eSpark-Backup/salah-el-din-fitness-tracker/docs/Dev-Files/Block Diagram/FitnessTracker.jpg

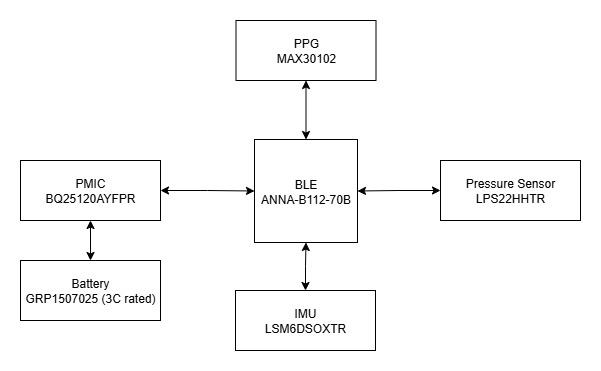
docs/Dev-Files/Block Diagram/FitnessTracker.jpg
