eSpark-Backup/salah-el-din-fitness-tracker/Design-Files/Fitness-Tracker-v1.0/Deliverables/Supporting Files/TrackerPCB-v1.0.step

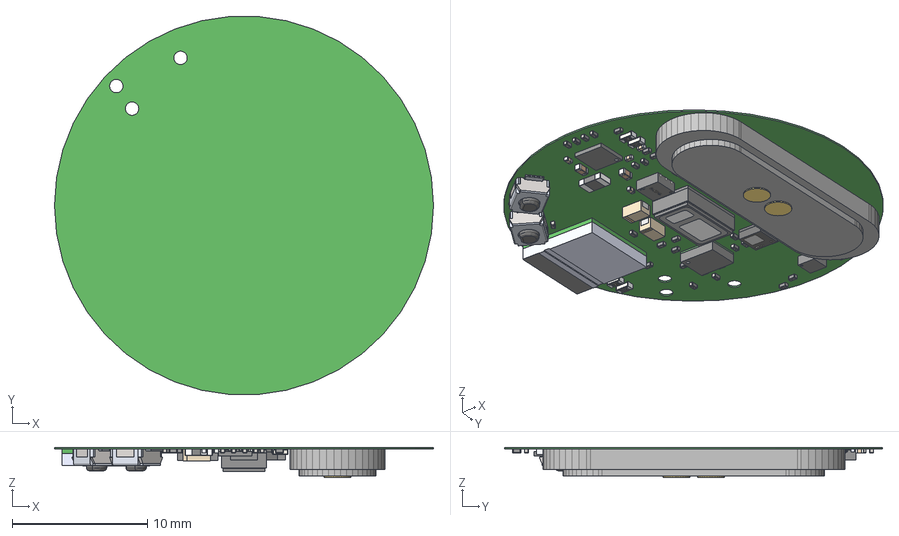
[picture p5: CAD file, 2025-08-07]
Design-Files/Fitness-Tracker-v1.0/Deliverables/Supporting Files/TrackerPCB-v1.0.step
28.0 x 27.9 x 2.22 mm
BQ29702DSER
User Library-0201(0603M) Res x 30
CAP_TR8M_VIS x 2
User Library-SMD Ceramic Capacitors_0201 (0603)_AB x 9
LSM6DSLTR--3DModel-STEP-269445
MAX30102EFD+T
ANNA-B112--3DModel-STEP-56544
User Library-OMRON B3U1000P x 2
User Library-RES_1005-0402 x 4
Extruded x 4
User Library-Capacitor 0402 x 2
