eSpark-Backup/salah-el-din-fitness-tracker/Design-Files/Fitness-Tracker-v1.0/Schematic/Fitness-Tracker-v1.0.pdf

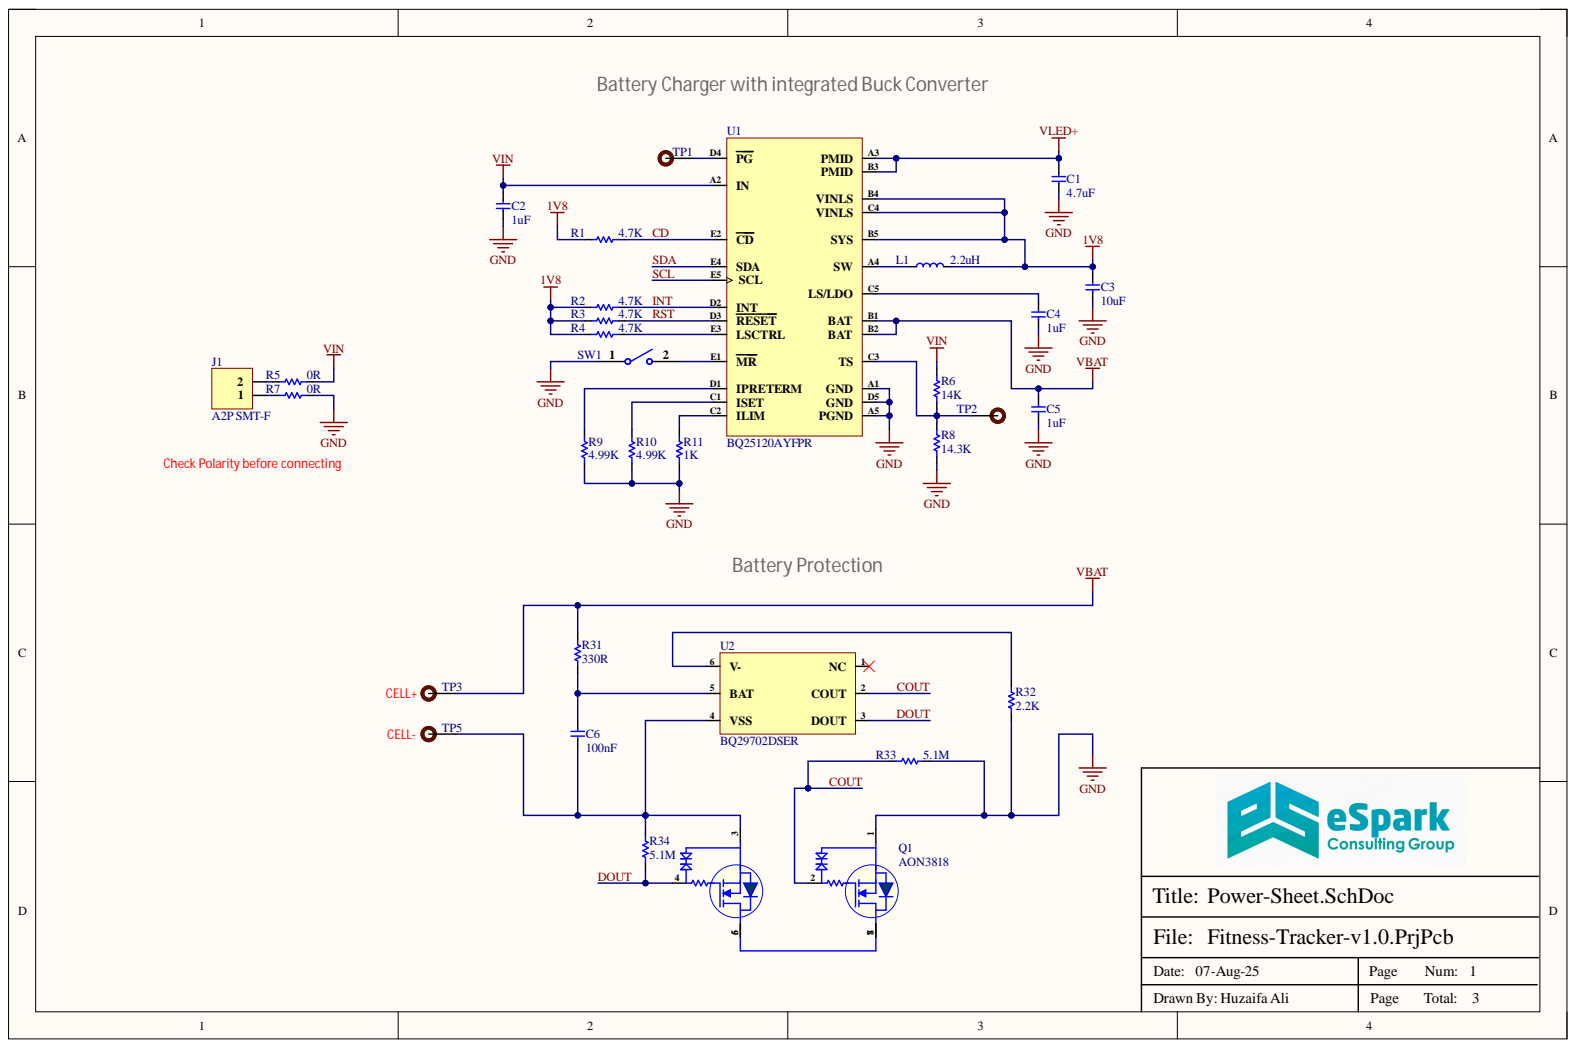
[picture p6: page 1]

Battery Charger with integrated Buck Converter

R3 | 4.7K RST
R4 | 4.7K | VIN 14.3K

Check Polarity before connecting

Date: 07-Aug-25 | Page Num: 1

Drawn By: Huzaifa Ali | Page Total: 3

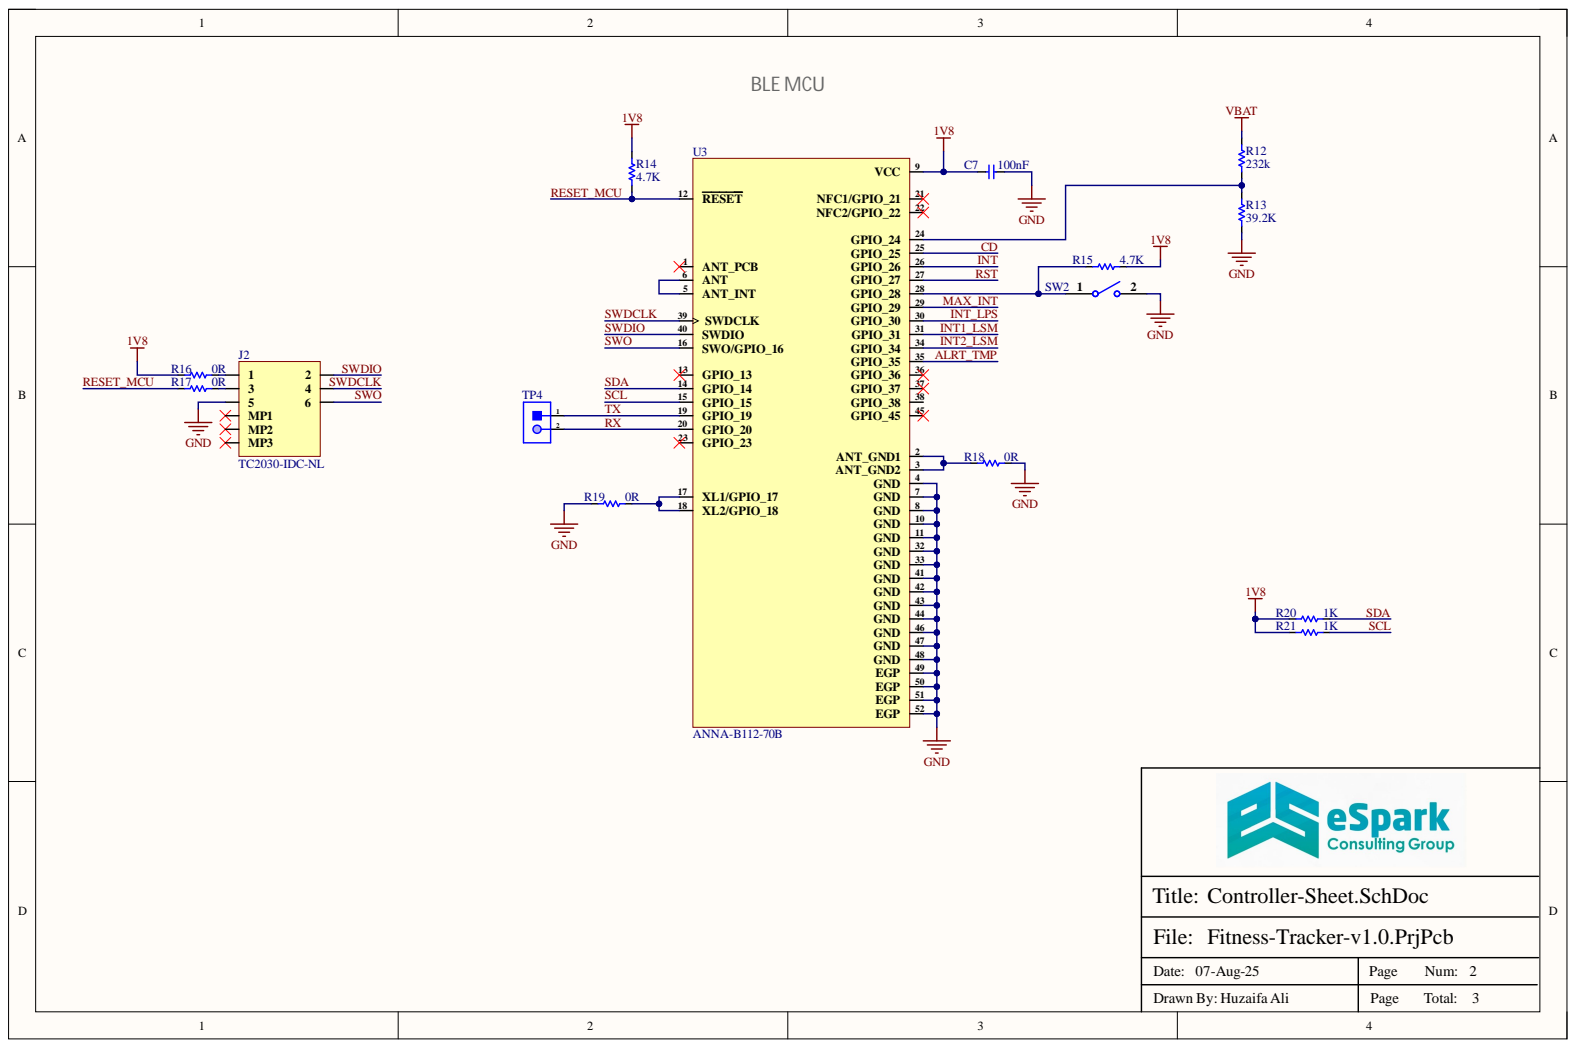
[picture p7: page 2]

Dat e : 0 7 -A u g -2 5 | Pag e N u m : 23

D raw n B y : H uzai fa A l i | Pag e To t al :

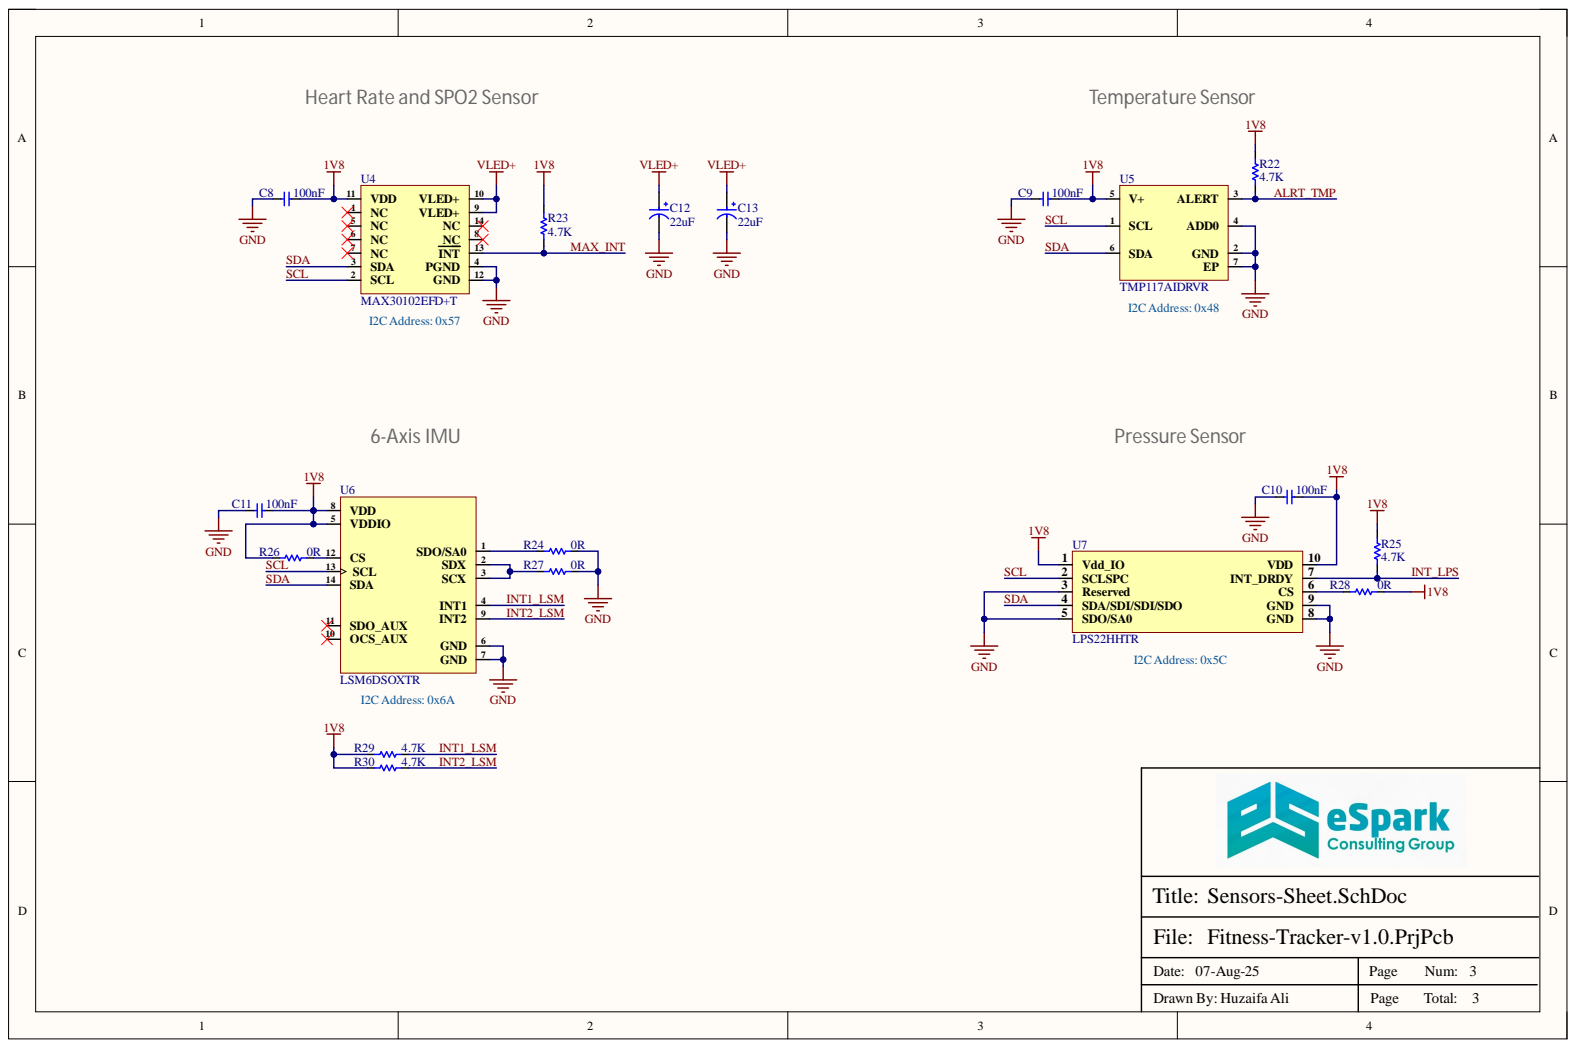
[picture p8: page 3]

Date: 07-Aug-25 | Page Num: 3

Drawn By: Huzaifa Ali | Page Total: 3
