eSpark-Backup/salah-el-din-fitness-tracker/docs/Client-Files/Hiyd Simplified Path.pdf

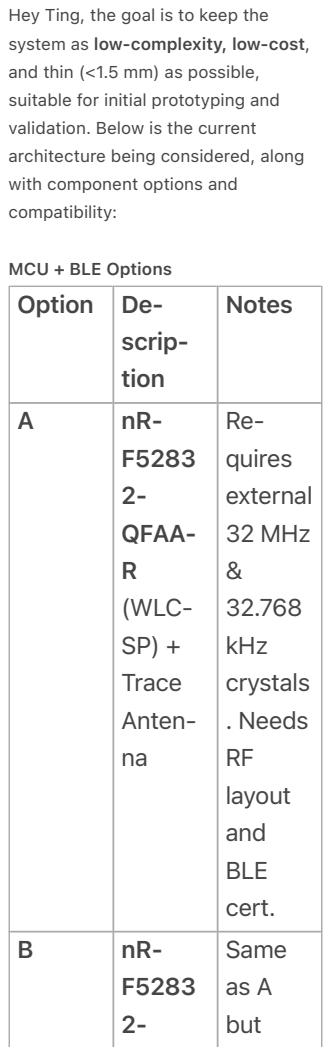
[picture p9: page 1]
scrip- tion; Notes; F5283 2- QFAA- R (WLC- SP) + Trace Anten- na; Re- quires external 32 MHz & 32.768 kHz crystals . Needs RF layout and BLE cert.; F5283 2- QFAA- R +; Same as A but

Hey Ting, the goal is to keep the
system as low-complexity, low-cost,
and thin (<1.5 mm) as possible,
suitable for initial prototyping and
validation. Below is the current
architecture being considered, along
with component options and
compatibility:

MCU + BLE Options
Option De-

## QFAA-

R +

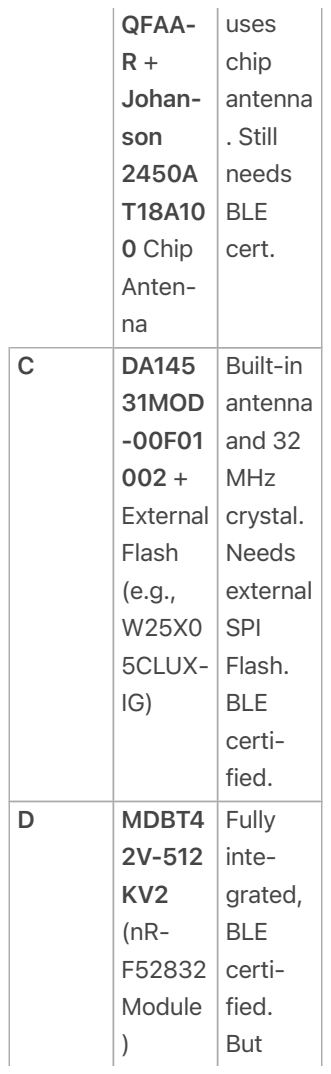
[picture p10: page 2]
Johan- son 2450A T18A10 0 Chip Anten- na; but uses chip antenna . Still needs BLE cert.; 31MOD -00F01 002 + External Flash (e.g., W25X0 5CLUX- IG); Built-in antenna and 32 MHz crystal. Needs external SPI Flash. BLE certi- fied.; MDBT4; 2V-512 KV2 (nR- F52832 Module ); Fully inte- grated, BLE certi- fied. But

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
## But

~2.5
mm

## thick (too thick for form

factor).

Core Sensors +
Components (compatible with all options unless noted)
PPG Sensor: MAX30102.
IMU: LSM6DSOXTR - single
unit, no longer separate
components as per original spec.
Barometer: LPS22HHTR - new addition.
Temperature Sensor: No longer applicable.
PMIC: BQ25120AYFPT.
Flash: Only needed for Option C (e.g., W25X05CLUXIG).
Battery: LPCV170726.
Crystals:
32 MHz (e.g., TXC
9HT30-32.000M) –
required for Options A &
B.
32.768 kHz (e.g.,
Abracon ABS07) –
optional RTC crystal.

Design Considerations
Form factor: Max height <1.5 mm (MDBT42V form factor is not ideal).
Preference for certified

●

●

●

●

●

modules (Options C/D) to
simplify RF compliance.
This is strictly a Proof-of-Concept, so minimal BOM and simplified design is the priority.

Let me know if you can help with: Architecture recommendation for using Nordic vs Dialogue MCU given the overall goal. Recommending layout or
integration best practices. Schematic, layout and firmware for this PoC .
