eSpark-Backup/salah-el-din-fitness-tracker/(list of files, drawings)

Other design files:
Design-Files/Fitness-Tracker-v1.0/Controller-Sheet.SchDoc
Design-Files/Fitness-Tracker-v1.0/Fitness-Tracker-v1.0.PrjPcb
Design-Files/Fitness-Tracker-v1.0/Power-Sheet.SchDoc
Design-Files/Fitness-Tracker-v1.0/Sensors-Sheet.SchDoc
Design-Files/Fitness-Tracker-v1.0/TrackerPCB-v1.0.PcbDoc
