eSpark-Backup/salah-el-din-fitness-tracker/(commit log)

2025-08-04 #1 In Progress
    [Controller-Sheet.SchDoc, Fitness-Tracker-v1.0.PrjPcb, Power-Sheet.SchDoc, Sensors-Sheet.SchDoc]
2025-08-05 #1 Complete
    [Controller-Sheet.SchDoc, Fitness-Tracker-v1.0.PrjPcb, Power-Sheet.SchDoc, Sensors-Sheet.SchDoc]
2025-08-06 #1 Pogo connector updated
    [Power-Sheet.SchDoc]
2025-08-07 #1 Changes for simplify PCB
    [Controller-Sheet.SchDoc, Power-Sheet.SchDoc]
2025-08-07 #2 #1 TVS removed, PCB placement in finalizing process
    [Controller-Sheet.SchDoc, Fitness-Tracker-v1.0.PrjPcb, TrackerPCB-v1.0.PcbDoc]
2025-08-07 #1 Battery protection added.
    [Power-Sheet.SchDoc]
2025-08-07 #1 Capacitor changed
    [Sensors-Sheet.SchDoc]
2025-08-07 #2 Step file - 0.12mm PCB (including coverlay)
    [TrackerPCB-v1.0.PcbDoc, TrackerPCB-v1.0.step]
